AeryJonesLab/Cricket-Dispenser/Cricket_Dispenser_Files/Arduino_Scripts/Dispenser_Pinout.txt

D2  - Servo feedback (yellow wire)
D9  - Servo control (white wire)
VIN - Servo power (red wire)
GND - Servo ground (black wire)
A0  - Movement TTL output
GND - Arduino pin to ONIX Board
