AeryJonesLab/Cricket-Dispenser/Cricket_Dispenser_Files/Dispenser_Parts_List.xlsx

Sheet: Dispenser Parts list
Purpose | Name | Vendor | Catalog # | Quantity | Unit Price | Total | Item type | Purpose | Notes/ Alternatives
Printing | Resin 3D printer (SLA/MSLA; Form 3 example) | Formlabs / equivalent |  | 1 | $1500.00 | $1500.00 | Tool / equipment | Print the 3D parts for the dispenser | Example only; refurbished model used, but may be able to print to order parts through Formlabs' printing service.
Printing | Form 3 Resin Tank (for Form 3 printer) | Printer manufacturer | RT-F3-02-01 | 1 | $149.00 | $149.00 | Tool / equipment | Hold resin inside the chosen resin printer | Not needed if outsourcing to printing service.
Printing | Printer-compatible general-purpose resin, 1 L (Formlabs White V4.1 example) | Formlabs / equivalent | RS-F2-GPWT-41 | 1 | $159.00 | $159.00 | Consumable | Print the 3D printed carousel, buckets, housing, and caps | Any compatible resin color; white is not required. Only .100 mm layer specification tested on this project.
Printing | Putty Knife (steel) | Lowes | 785603 | 1 | $7.98 | $7.98 | Tool / equipment | Remove printed parts from the build plate
Printing | Compatible resin wash solution / solvent | Compatible supplier | SLN-RW-01 | 1 | $75.00 | $75.00 | Consumable | Wash uncured resin off printed parts | Isopropyl alcohol can be used
Print Processing | Flush cutters | Lowes | 5427360 | 1 | $12.97 | $12.97 | Tool / equipment | Snip print supports and trim plastic components
Print Processing | 1000 grit sandpaper | Lowes | 5639329 | 1 | $9.98 | $9.98 | Consumable | Smooth fine edges of printed parts
Print Processing | Water bath container | Amazon | B0FT2XK2QZ | 1 | $28.99 | $28.99 | Tool / equipment | Hold water for rinsing/cleaning, as appropriate for curing workflow | Any suitable wash/rinse container
Print Processing | Sandpaper (200 grit for example) | Lowes | 6014054 | 1 | $8.98 | $8.98 | Consumable | Remove rough spots, support marks, and improves fit | Can experiment with different grit sandpapers depending on print resin used.
Print Processing | Digital calipers | Lowes | 4882351 | 1 | $39.98 | $39.98 | Tool / equipment | Measure printed dimensions, pins, and clearances
Assembly | Adhesive Teflon Tape | McMaster | 76445A721 | 1 | $3.45 | $3.45 | Consumable | Reduce friction / improve fit at selected rubbing interfaces
Assembly | Loctite Super Glue | Lowes | 461132 | 1 | $5.98 | $5.98 | Consumable | Bond/secure small components during assembly
Assembly | 3 × 6 mm Dowel Pins | McMaster | 97049A205 | 1 | $15.44 | $15.44 | Component | 3 × 6 mm hinge/retention pins (8 per dispenser)
Assembly | 5/16" × 1" Dowel Pins | McMaster | 98381A583 | 1 | $14.40 | $14.40 | Component | 5/16" × 1" pivot pins for individual buckets (8 per dispenser)
Assembly | 3 × 6 × 2.5 mm Ball Bearings | Amazon | B00ZHSQX42 | 4 | $7.08 | $28.32 | Component | 3 × 6 × 2.5 mm bearings at moving bucket/hinge assemblies (16 per dispenser)
Assembly | Putty Knife (plastic) | Lowes | 5759259 | 1 | $2.08 | $2.08 | Tool / equipment | Scrape/separate delicate resin parts without a metal edge
Cricket Procurement | Garden Netting | Amazon | B087RSWLY8 | 1 | $7.59 | $7.59 | Habitat supply | Provide airflow / ventilation in cricket holding enclosure
Cricket Procurement | Magnetic Strips | Amazon | B078SVG2CC | 1 | $5.99 | $5.99 | Habitat supply | Secure removable habitat cover or netting
Cricket Procurement | Flat-head wood screws (1 in.) | Amazon / hardware supplier | B09WCXS3NV | 1 | $13.18 | $13.18 | Habitat supply | Attach netting or habitat hardware to enclosure | Hot glue/ caulk works just as well
Cricket Procurement | Vermiculite (cricket egg-laying substrate) | VWR / lab supplier | VWR-470021-148-PK | 1 | $10.29 | $10.29 | Habitat consumable | Provides habitat bedding
Cricket Procurement | Blackout Curtain 42x63 | Amazon | B01GCLYV5K | 1 | $11.83 | $11.83 | Habitat equipment | Block external lighting / isolate cricket enclosure
Cricket Procurement | Tension rod 28-48" | Amazon | B0C4DVXGH7 | 2 | $13.49 | $26.98 | Habitat equipment | Hang/support a blackout curtain
Cricket Procurement | 64 qt Bin | Amazon | B081ZR2BCC | 1 | $44.99 | $44.99 | Habitat equipment | House and maintain live crickets | Comes in a 2pk, can find cheaper alternative, such as linked item (https://www.walmart.com/ip/Sterilite-66qt-Latch-Box-Stadium-Blue/202840819?wmlspartner=wlpa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)
Cricket Procurement | Cricket Diet Cubes | Flukers | N/A | 1 | $11.53 | $11.53 | Habitat consumable | Feed and hydrate crickets in holding enclosure | Alternative: food scraps
Cricket Procurement | Crickets (Small) | Flukers | N/A | 2 | $6.90 | $13.80 | Habitat consumable | Prey
Cricket Procurement | Reusable arm-length rubber gloves | Amazon | B08MZKLGSJ | 1 | $9.90 | $9.90 | Habitat equipment | Modified cricket habitat glove | Optional
Cricket Procurement | Gravel (cricket habitat) | VWR / lab supplier | VWR-470012-936-EA | 1 | $10.49 | $10.49 | Habitat supply | Provide drainage/structure in cricket-holding setup | Optional; suggested for drainage if providing fresh water source
Cricket Procurement | Cricket habitat lighting | Amazon | B0FSZVW4ND | 1 | $16.99 | $16.99 | Habitat equipment | Maintain the desired cricket light/dark schedule | Optional
Motor Wiring | Parallax Feedback 360° High-Speed Servo | Mouser | 900-00360 | 2 | $27.99 | $55.98 | Component | Rotate the carousel using PWM position feedback
Motor Wiring | BNC Male Jack for ONIX | Digikey | 501-1031-ND | 2 | $19.49 | $38.98 | Optional component | Transmit TTL synchronization to ONIX recording hardware | Optional
Motor Wiring | ESD forceps | Amazon | B0CLH2DTQ2 | 1 | $7.98 | $7.98 | Tool / equipment | Hold tiny wiring or printed parts during assembly
Motor Wiring | Heat shrink tubing | Amazon | B0722HN8SW | 1 | $11.99 | $11.99 | Consumable | Insulate soldered electrical connections
Motor Wiring | Arduino Uno R3 screw-terminal breakout (B07HF2DD7T) | Amazon | B07HF2DD7T | 2 | $18.99 | $37.98 | Component | Provide screw-terminal connections that fit the Uno R3 pin layout.
Motor Wiring | Arduino Uno R3 | Amazon | B008GRTSV6 | 2 | $27.60 | $55.20 | Component | Run the supplied servo-control sketch and assign trigger/feedback pins according to the Uno R3 pinout
Motor Wiring/Assembly | Heat Gun | Lowes | 5136229 | 1 | $34.99 | $34.99 | Tool / equipment | Shrink heat-shrink tubing and aid bearing fitting
Motor Wiring | Soldering Iron | Lowes | 6830559 | 1 | $62.99 | $62.99 | Tool / equipment | For soldering joints
Motor Wiring | Fume extractor | Lowes | 5082578 | 1 | $79.92 | $79.92 | Tool / equipment | Vent/filter solder fumes
Motor Wiring | 24 AWG twisted-pair wire | Jameco | 105807 | 1 | $129.95 | $129.95 | Consumable | Used to join servo wiring to Arduino | Can purchase much less wiring for this assembly
Motor Wiring | Solder Flux | Lowes | 797867 | 2 | $3.80 | $7.60 | Consumable | Improve electrical conduction of joints. | Only need small amount
Motor Wiring | Lead-Free Solder | Lowes | 113443 | 1 | $20.98 | $20.98 | Consumable | Soldering joints | Only need small amount
Motor Wiring | Precision Screwdrivers | Lowes | 8009736 | 1 | $17.99 | $17.99 | Tool / equipment | Fasten Arduino screw terminal and attach axle part to servo wheel
Motor Wiring | Multimeter | Lowes | 2545069 | 1 | $24.98 | $24.98 | Tool / equipment | Check reliability of soldered joints
Motor Wiring | Male to Male Jumper Cables | Jameco | 2507559 | 1 | $2.59 | $2.59 | Component | For connecting to servo wires and placing into screw terminal.
Mounting | T-slot framing, 6 in. | McMaster | 47065T102 | 2 | $9.85 | $19.70 | Mount component | Mount dispenser | Optional; another dispenser mounting
Mounting | 1.5 in. T-slot brackets | McMaster | 47065T845 | 10 | $9.38 | $93.80 | Mount component | Join extrusion pieces and fasten dispenser mount | Optional
Mounting | Allen Wrench 5/8" |  |  |  |  |  | Tool / equipment | Tighten mounting bolts
Mounting | 43 in. ultralight T-slot framing, 1.5 × 1.5 in. | 80/20 | 1515-UL | 2 | $36.11 | $72.22 | Mount component | Support dispenser above arena on upright extrusion

Sheet: Printed Parts List
Part | Quantity for 1 Dispenser | Function
Servo Encaser | 1 | Houses and stabilizes feedback servo
Servo Axle | 1 | Couples servo output to the carousel
Hoop | 1 | Supports buckets and their guided rotation
Bucket Holder | 1 | Holds and positions the eight buckets
Octocap Hub | 1 | Retains/opens the rotating caps
Buckets | 8 | Hold individual crickets (8 per dispenser)
Angled Caps | 8 | Prevent escape until dispensing (8 per dispenser)

Sheet: Assembly Cost
Purpose | Name | Price | Pack / Batch Qty | Qty / Dispenser | Unit | Cost / Dispenser
Printing | General-purpose resin (FormLabs White V4.1 used for price) | $66.65 | 526.07 | 263.035 | mL | $33.33
Printing | Compatible resin wash solution / solvent (FormLabs) | $75.00 | 1 | 0.03 | bottle | $2.25
Print Processing | 1000 grit sandpaper | $9.98 | 1 | 0.1666666667 | pack | $1.66
Print Processing | 200 grit sandpaper | $8.98 | 1 | 0.1666666667 | pack | $1.50
Assembly | Adhesive Teflon Tape | $3.45 | 1 | 0.1 | roll | $0.35
Assembly | Loctite Super Glue | $5.98 | 1 | 0.05 | tube | $0.30
Assembly | 3 × 6 mm Dowel Pins | $15.44 | 100 | 8 | pins | $1.24
Assembly | 5/16" × 1" Dowel Pins | $14.40 | 100 | 8 | pins | $1.15
Assembly | 3 × 6 × 2.5 mm Ball Bearings | $7.08 | 8 | 16 | bearings | $14.16
Motor Wiring | Parallax Feedback 360° High-Speed Servo | $27.99 | 1 | 1 | servo | $27.99
Motor Wiring | Heat shrink tubing | $11.99 | 1 | 0.05 | pack | $0.60
Motor Wiring | Arduino Uno R3 screw-terminal breakout (OPTIONAL) | $18.99 | 1 | 0 | board | $0.00
Motor Wiring | Arduino Uno R3 | $27.60 | 1 | 1 | board | $27.60
Motor Wiring | 24 AWG twisted-pair wire | $129.95 | 1 | 0.05 | spool | $6.50
Motor Wiring | Solder Flux | $3.80 | 1 | 0.03 | container | $0.11
Motor Wiring | Lead-Free Solder | $20.98 | 1 | 0.02 | spool | $0.42
Motor Wiring | Male to Male Jumper Cables | $2.59 | 1 | 0.5 | pack | $1.29
Total per dispenser, mounting not included |  |  |  |  |  | $120.44
Optional ONIX | BNC Male Jack for ONIX | $19.49 | 1 | 1 | connector | $19.49
