AeryJonesLab/Cricket-Dispenser/Cricket_Dispenser_Files/STEP/Bucket Holder.step

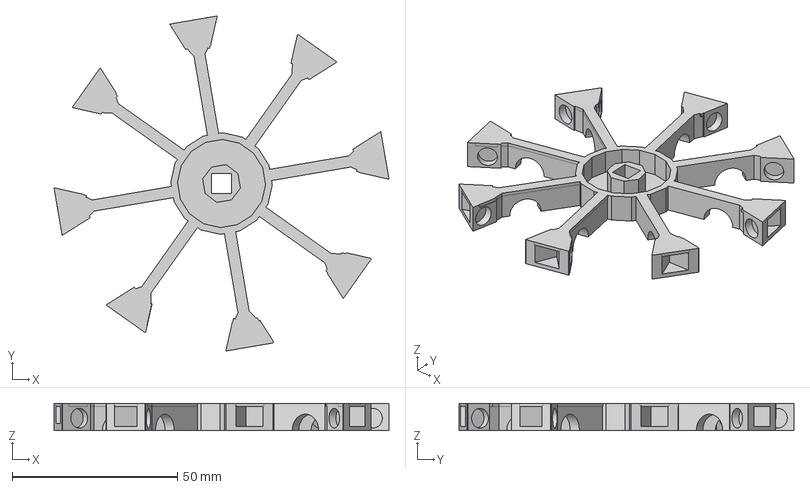
[picture p1: CAD file, 2026-10-13]
Cricket_Dispenser_Files/STEP/Bucket Holder.step
101.4 x 101.4 x 8.27 mm
