AeryJonesLab/Cricket-Dispenser/Cricket_Dispenser_Files/STEP/Bucket.step

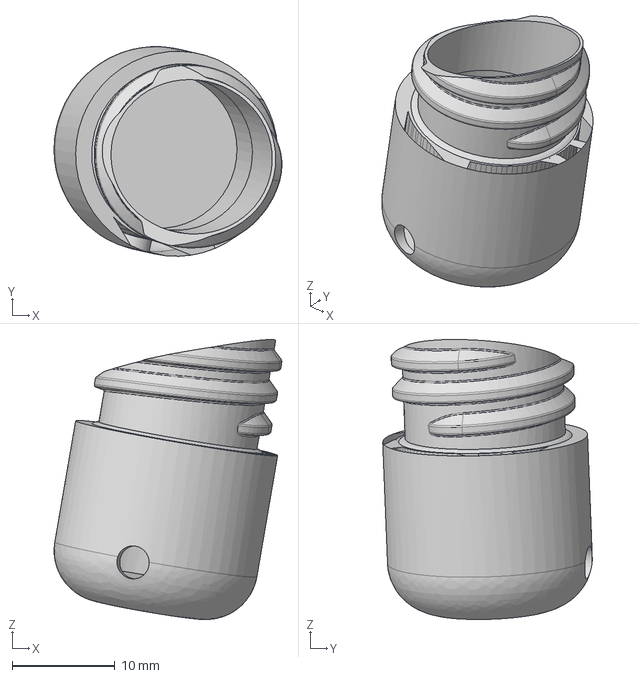
[picture p2: CAD file, 2026-10-13]
Cricket_Dispenser_Files/STEP/Bucket.step
22.2 x 20.4 x 27.3 mm
