AeryJonesLab/Cricket-Dispenser/Cricket_Dispenser_Files/STEP/Hoop.step

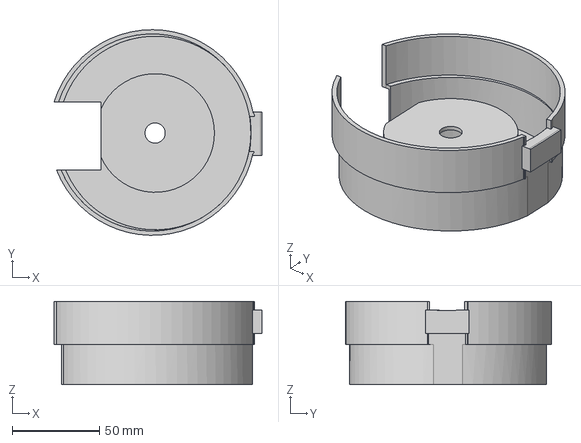
[picture p3: CAD file, 2026-10-13]
Cricket_Dispenser_Files/STEP/Hoop.step
118.9 x 117.5 x 47.5 mm
