AeryJonesLab/Cricket-Dispenser/Cricket_Dispenser_Files/STEP/Cap Disk.step

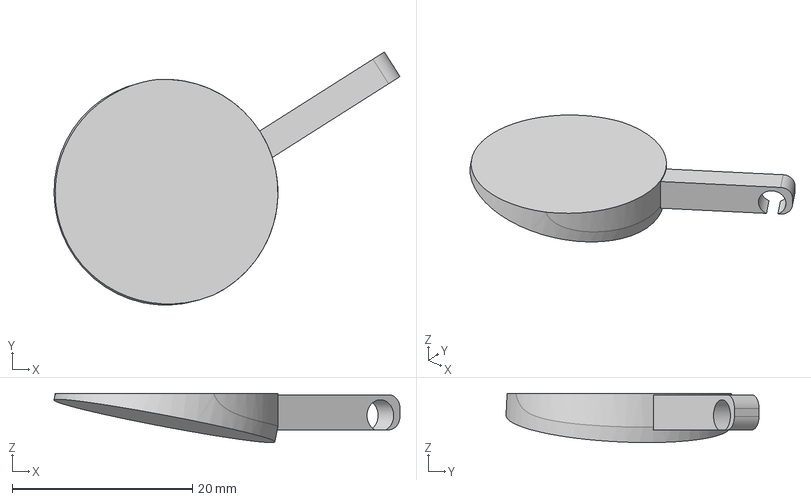
[picture p4: CAD file, 2026-10-13]
Cricket_Dispenser_Files/STEP/Cap Disk.step
38.4 x 28.1 x 5.46 mm
