AeryJonesLab/Cricket-Dispenser/Cricket_Dispenser_Files/STEP/Servo Encaser.step

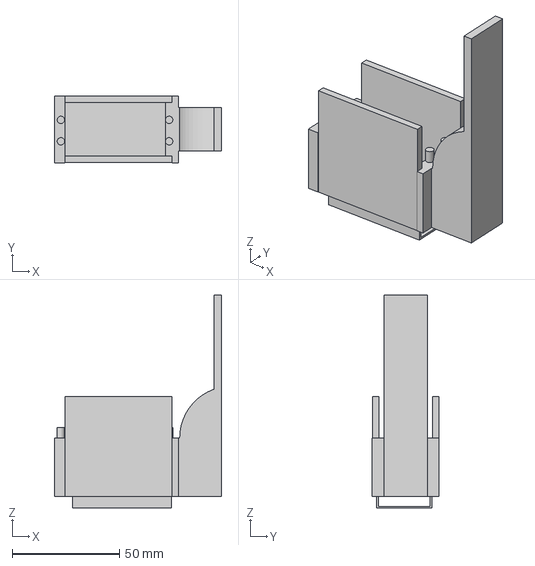
[picture p5: CAD file, 2026-10-13]
Cricket_Dispenser_Files/STEP/Servo Encaser.step
78.1 x 31.2 x 99.4 mm
