AeryJonesLab/Cricket-Dispenser/Cricket_Dispenser_Files/STEP/Servo Axle.step

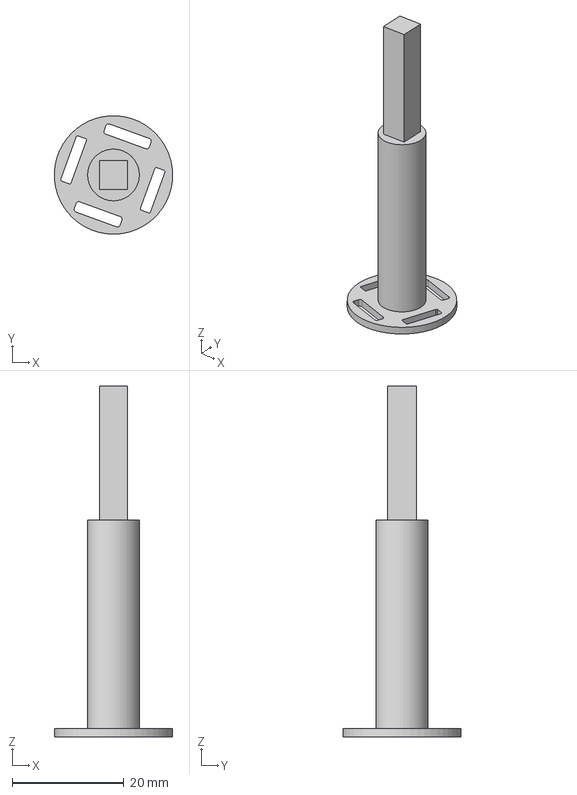
[picture p6: CAD file, 2026-10-13]
Cricket_Dispenser_Files/STEP/Servo Axle.step
21.2 x 21.2 x 62.8 mm
