AeryJonesLab/Cricket-Dispenser/Cricket_Dispenser_Files/STEP/Octocap Hub.step

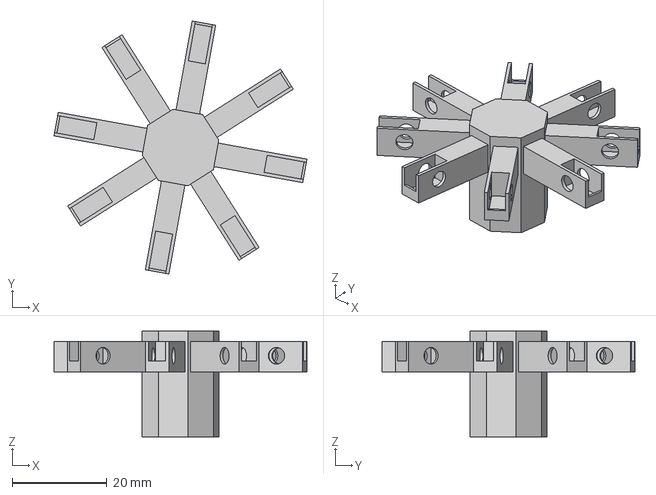
[picture p7: CAD file, 2026-10-13]
Cricket_Dispenser_Files/STEP/Octocap Hub.step
53.3 x 53.3 x 22.3 mm
