AeryJonesLab/Cricket-Dispenser/(list of files, cad)

Other CAD files:
Cricket_Dispenser_Files/Fusion/Final Cricket Dispenser.f3z
