AeryJonesLab/Cricket-Dispenser/(commit log)

2026-07-07 Add files via upload
    Edited ITI to be shorter for testing Arduino connections on Bonsai
2026-07-31 Create 7.31.26 Dispenser.f3z
    final edits on buckets, file clean up pt.1
    [7.31.26 Dispenser.f3z]
2026-10-13 final dispenser files commit
    Fusion, STEP and PreForm files.
    [Bucket Holder.step, Bucket.step, Cap Disk.step, Final Cricket Dispenser.f3z, Hoop.step, Octocap Hub.step, Servo Axle.step, Servo Encaser.step]
2026-10-14 Create Dispenser Parts list.xlsx
    [Dispenser Parts list.xlsx]
2026-10-15 Update Dispenser Parts list.xlsx
    updated parts list
    [Dispenser Parts list.xlsx]
2026-10-22 Addition of dispenser specific Arduino code.
2026-11-09 Remove outdated individual files
    [6.24.26 Cricket Dispenser.step, 7.31.26 Dispenser.f3z]
2026-11-10 Refine comments for servo control and turn counting
    Updated comments for clarity and accuracy in the code regarding turn counting and servo control.
2026-11-11 Updating folder names and README
    [Bucket Holder.step, Bucket.step, Cap Disk.step, Dispenser Parts list.xlsx, Final Cricket Dispenser.f3z, Hoop.step, Octocap Hub.step, Servo Axle.step]
2026-11-12 Arduino code major refactor
2026-11-12 updated material sheet
    [Dispenser Parts list.xlsx, Dispenser_Parts_List.xlsx]
2026-11-12 Minor updates to single dispenser expense calculation
    [Dispenser_Parts_List.xlsx]
